strfry/Elektrosluch/parts/3d/ptr901-2x15k-xxxx.stp

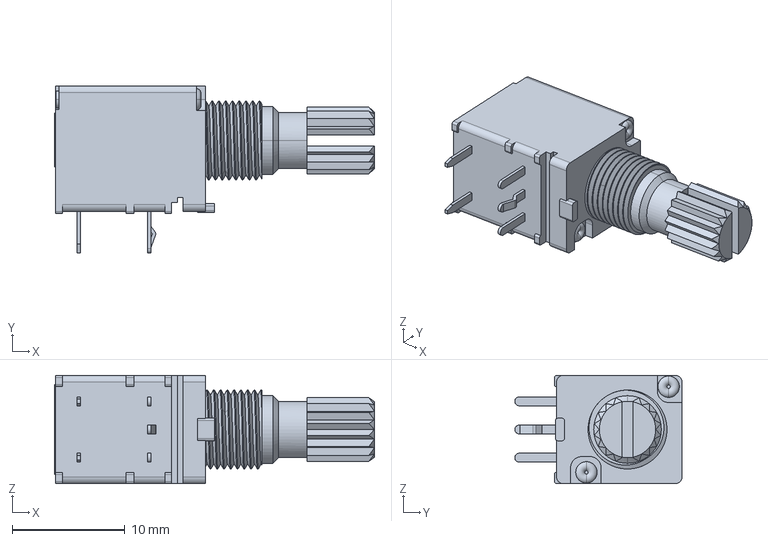
[picture p1: CAD file, 2020-03-24]
parts/3d/ptr901-2x15k-xxxx.stp
28.4 x 14.9 x 9.60 mm
