strfry/Elektrosluch/parts/3d/CUI_DEVICES_SJ1-3525N.step

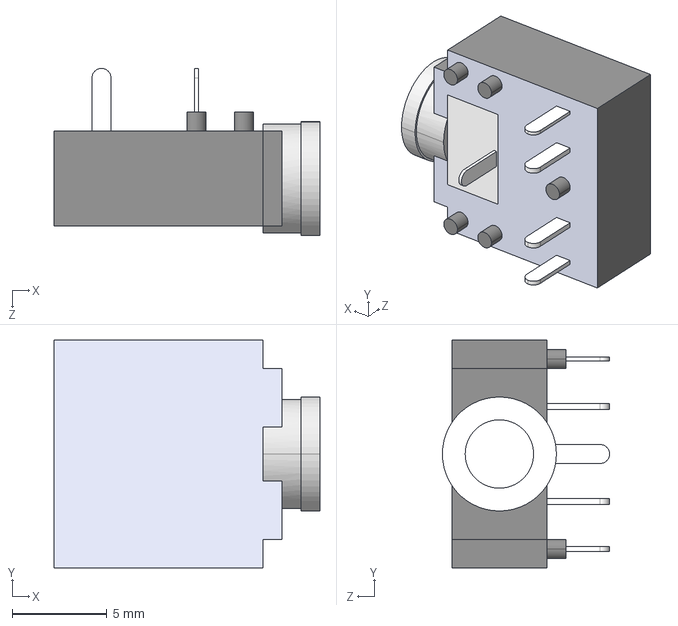
[picture p2: CAD file, 2020-03-24]
parts/3d/CUI_DEVICES_SJ1-3525N.step
14.0 x 12.0 x 8.80 mm
