strfry/Elektrosluch/elektrosluch2.sch

## KiCad design elektrosluch2.sch (2020-03-24)

Schematic: elektrosluch2.sch

Parts:
BT1: Battery; xess-KEYSTONE-593+594
C1, C2, C5, C6: 2.2u
C3, C4: 47p
C7, C8: CP
D1: LED
H1, H2, H3, H4: MountingHole_Pad
J1: AudioJack3_SwitchTR; Headphone_Jack_3.5mm_SJ1-3525N
J2: AudioJack3
L1, L2: 22mH
R1, R2: 1K
R3, R4: 390K
R5, R6: 100k
R7: 1k
U1: TL072
